Kbij/VentControl/README.md

# VentControl

Firmware for a custom made RP-2040 board with relays. Used for Ventilation control.
