Kbij/VentControl/pcb/Ventilator/R-78AA3.3-1.0SMD/R-78AA3.3-1.0SMD.step

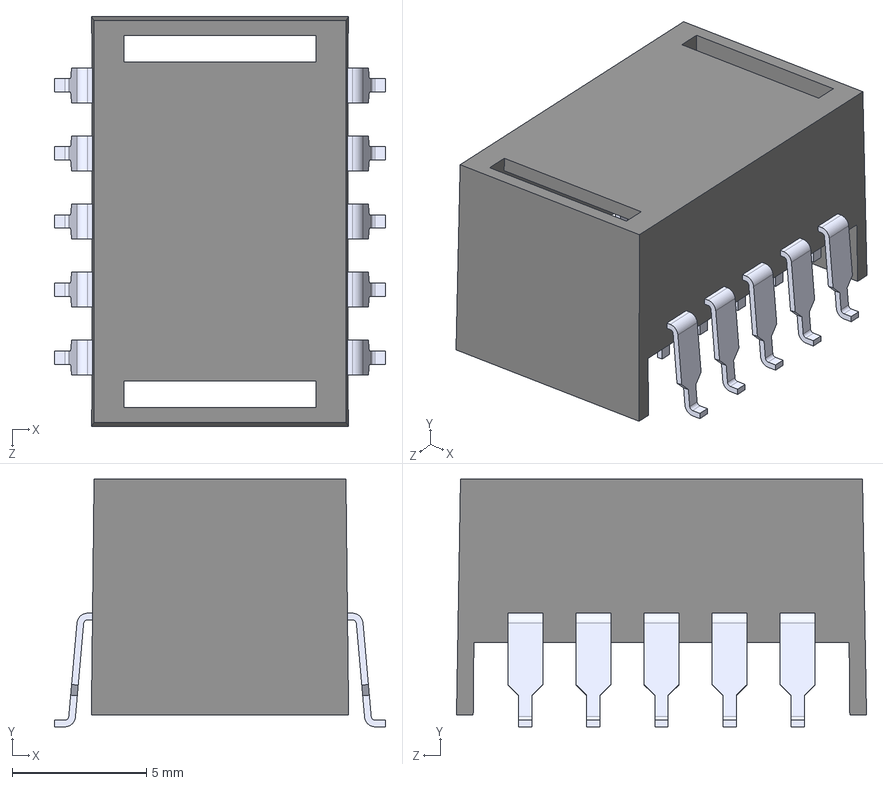
[picture p1: CAD file, 2022-12-26]
pcb/Ventilator/R-78AA3.3-1.0SMD/R-78AA3.3-1.0SMD.step
12.3 x 9.24 x 15.3 mm
