Kbij/VentControl/pcb/Ventilator/Ventilator.kicad_pcb

## KiCad design pcb/Ventilator/Ventilator.kicad_pcb (2023-04-06)

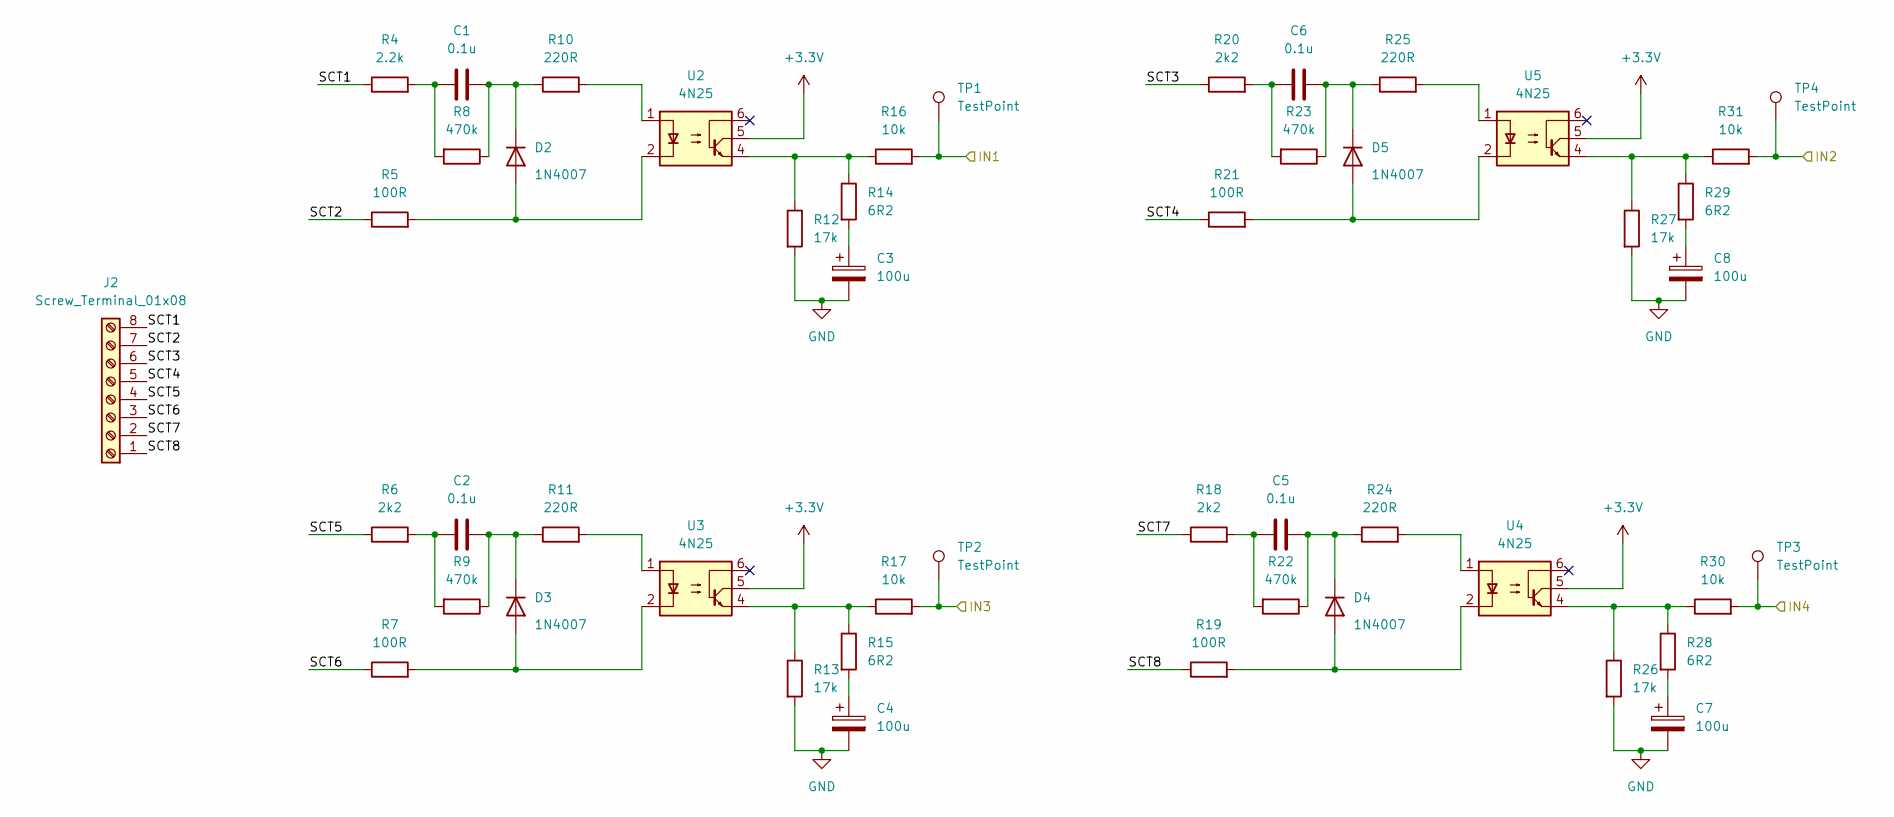
[picture p2: schematic Input.kicad_sch]

Parts:
C1, C2, C5, C6: 0.1u; C_Rect_L18.0mm_W5.0mm_P15.00mm_FKS3_FKP3
C3, C4, C7, C8: 100u; C_1206_3216Metric_Pad1.33x1.80mm_HandSolder
D2, D3, D4, D5: 1N4007; D_DO-41_SOD81_P10.16mm_Horizontal
J2: Screw_Terminal_01x08; TerminalBlock_Phoenix_MKDS-1,5-8_1x08_P5.00mm_Horizontal
R4: 2.2k; R_2512_6332Metric
R5, R7, R19, R21: 100R; R_0805_2012Metric_Pad1.20x1.40mm_HandSolder
R6, R18, R20: 2k2; R_2512_6332Metric
R8, R9, R22, R23: 470k; R_2512_6332Metric
R10, R11, R24, R25: 220R; R_0805_2012Metric_Pad1.20x1.40mm_HandSolder
R12, R13, R26, R27: 17k; R_0805_2012Metric_Pad1.20x1.40mm_HandSolder
R14, R15, R28, R29: 6R2; R_0805_2012Metric_Pad1.20x1.40mm_HandSolder
R16, R17, R30, R31: 10k; R_0805_2012Metric_Pad1.20x1.40mm_HandSolder
TP1, TP2, TP3, TP4: TestPoint; TestPoint_Bridge_Pitch2.54mm_Drill1.0mm
U2, U3, U4, U5: 4N25; DIP-6_W7.62mm

Connections:
+3.3V: U2.5, U3.5, U4.5, U5.5; also elsewhere on the board
/CPU/IN1: R16.2, TP1.1; also elsewhere on the board
/CPU/IN2: R31.2, TP4.1; also elsewhere on the board
/CPU/IN3: R17.2, TP2.1; also elsewhere on the board
/CPU/IN4: R30.2, TP3.1; also elsewhere on the board
/Input/SCT1: J2.8, R4.1; also elsewhere on the board
/Input/SCT2: J2.7, R5.1; also elsewhere on the board
/Input/SCT3: J2.6, R20.1; also elsewhere on the board
/Input/SCT4: J2.5, R21.1; also elsewhere on the board
/Input/SCT5: J2.4, R6.1; also elsewhere on the board
/Input/SCT6: J2.3, R7.1; also elsewhere on the board
/Input/SCT7: J2.2, R18.1; also elsewhere on the board
/Input/SCT8: J2.1, R19.1; also elsewhere on the board
GND: C3.2, C4.2, C7.2, C8.2, R12.2, R13.2, R26.2, R27.2; also elsewhere on the board
unnamed 30: C1.1, D2.1 (K), R8.1, R10.1; also elsewhere on the board
unnamed 31: C1.2, R4.2, R8.2; also elsewhere on the board
unnamed: C2.1, D3.1 (K), R9.1, R11.1
unnamed: C2.2, R6.2, R9.2
unnamed: C3.1, R14.2
unnamed: C4.1, R15.2
unnamed: C5.1, D4.1 (K), R22.1, R24.1
unnamed: C5.2, R18.2, R22.2
unnamed: C6.1, D5.1 (K), R23.1, R25.1
unnamed: C6.2, R20.2, R23.2
unnamed: C7.1, R28.2
unnamed: C8.1, R29.2
unnamed: D2.2 (A), R5.2, U2.2
unnamed: D3.2 (A), R7.2, U3.2
unnamed: D4.2 (A), R19.2, U4.2
unnamed: D5.2 (A), R21.2, U5.2
unnamed: R10.2, U2.1
unnamed: R11.2, U3.1
unnamed: R12.1, R14.1, R16.1, U2.4
unnamed: R13.1, R15.1, R17.1, U3.4
unnamed: R24.2, U4.1
unnamed: R25.2, U5.1
unnamed: R26.1, R28.1, R30.1, U4.4
unnamed: R27.1, R29.1, R31.1, U5.4

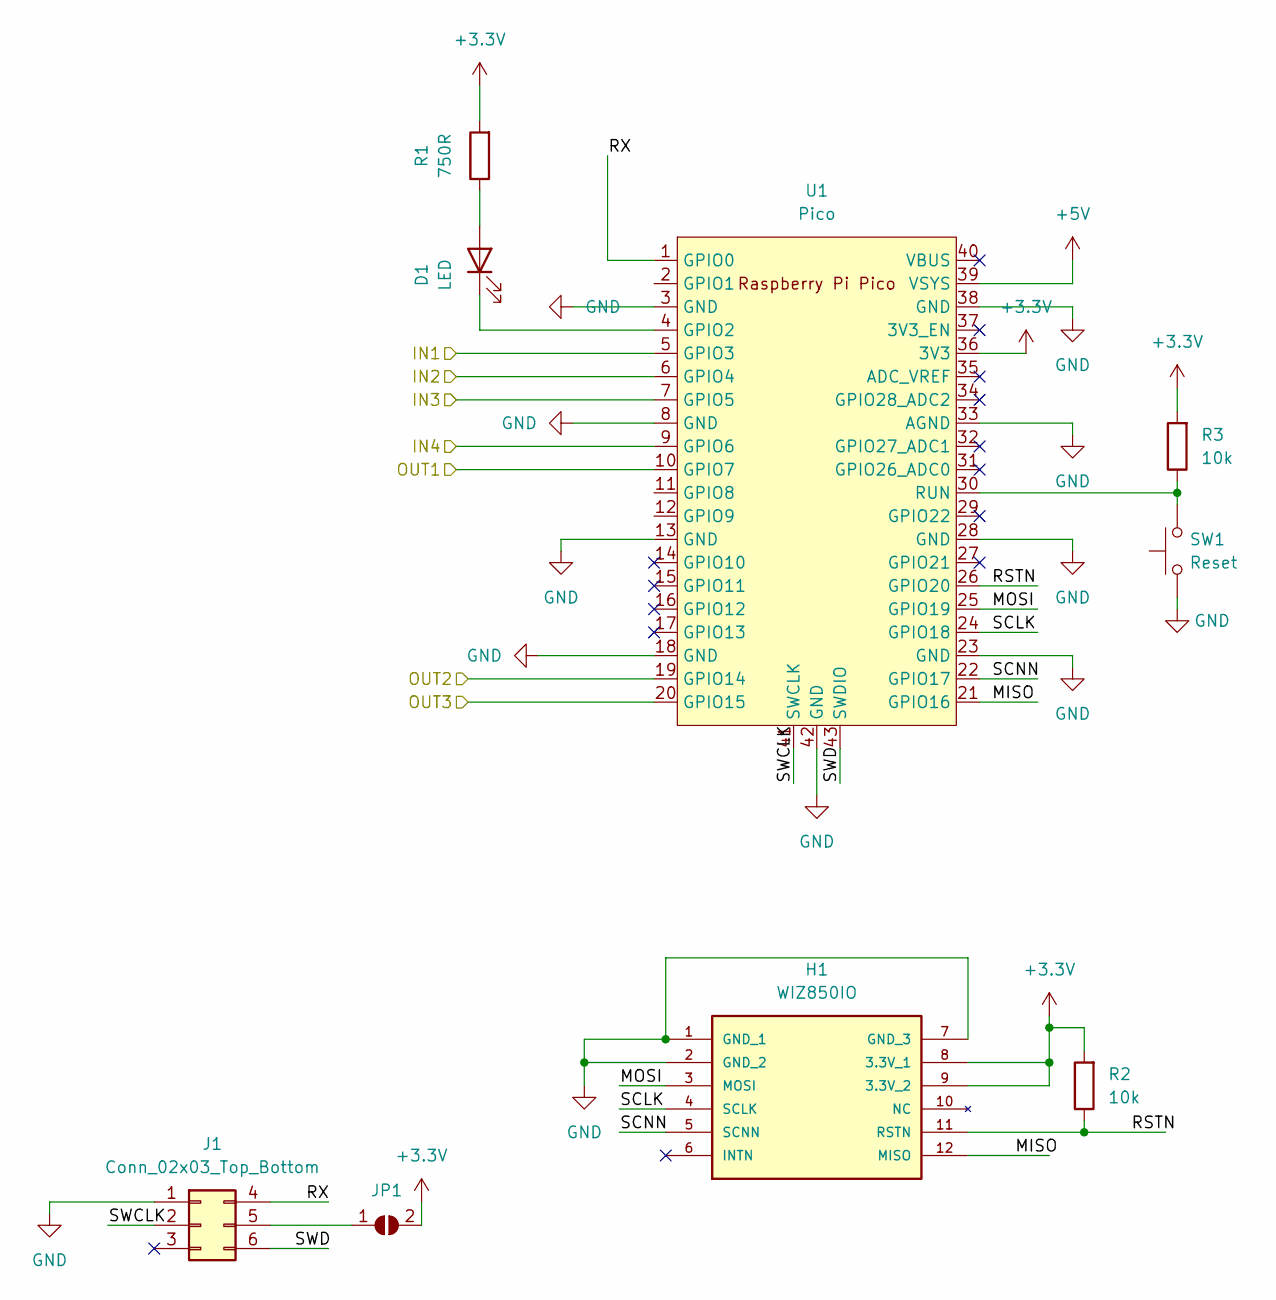
[picture p3: schematic cpu.kicad_sch]

Parts:
D1: LED; LED_D3.0mm
H1: WIZ850IO; MANUFACTURER_PART_NUMBER WIZ850IO
J1: Conn_02x03_Top_Bottom; PinHeader_2x03_P2.54mm_Vertical
JP1: SolderJumper_2_Open
R1: 750R; R_0805_2012Metric_Pad1.20x1.40mm_HandSolder
R2, R3: 10k; R_0805_2012Metric
SW1: Reset; SW_SPST_EVPBF
U1: Pico; RPi_Pico_SMD_TH

Connections:
+3.3V: H1.8 (3.3V_1), H1.9 (3.3V_2), JP1.2 (B), R1.2, R2.2, R3.2, U1.36 (3V3); also elsewhere on the board
+5V: U1.39 (VSYS); also elsewhere on the board
/CPU/IN1: U1.5 (GPIO3); also elsewhere on the board
/CPU/IN2: U1.6 (GPIO4); also elsewhere on the board
/CPU/IN3: U1.7 (GPIO5); also elsewhere on the board
/CPU/IN4: U1.9 (GPIO6); also elsewhere on the board
/CPU/MISO: H1.12 (MISO), U1.21 (GPIO16)
/CPU/MOSI: H1.3 (MOSI), U1.25 (GPIO19)
/CPU/OUT1: U1.10 (GPIO7); also elsewhere on the board
/CPU/OUT2: U1.19 (GPIO14); also elsewhere on the board
/CPU/OUT3: U1.20 (GPIO15); also elsewhere on the board
/CPU/RSTN: H1.11 (RSTN), R2.1, U1.26 (GPIO20)
/CPU/RX: J1.4, U1.1 (GPIO0)
/CPU/SCLK: H1.4 (SCLK), U1.24 (GPIO18)
/CPU/SCNN: H1.5 (SCNN), U1.22 (GPIO17)
/CPU/SWCLK: J1.2, U1.41 (SWCLK)
/CPU/SWD: J1.6, U1.43 (SWDIO)
GND: H1.1 (GND_1), H1.2 (GND_2), H1.7 (GND_3), J1.1, SW1.1, U1.3 (GND), U1.8 (GND), U1.13 (GND), U1.18 (GND), U1.23 (GND), U1.28 (GND), U1.33 (AGND), U1.38 (GND), U1.42 (GND); also elsewhere on the board
unnamed: D1.1 (K), U1.4 (GPIO2)
unnamed: D1.2 (A), R1.1
unnamed: J1.5, JP1.1 (A)
unnamed: R3.1, SW1.2, U1.30 (RUN)

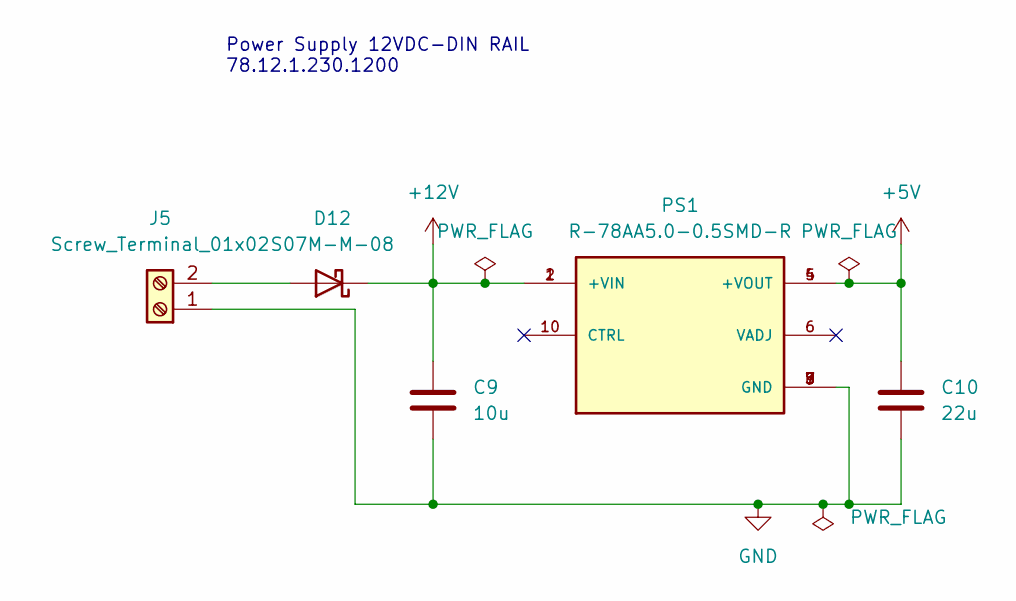
[picture p4: schematic Power.kicad_sch]

Parts:
C9: 10u; C_0805_2012Metric_Pad1.18x1.45mm_HandSolder
C10: 22u; C_0805_2012Metric_Pad1.18x1.45mm_HandSolder
D12: S07M-M-08; D_SMF
J5: Screw_Terminal_01x02; TerminalBlock_bornier-2_P5.08mm
PS1: R-78AA5.0-0.5SMD-R; CONV_R-78AA3.3-1.0SMD; PARTREV 5/2019

Connections:
+5V: C10.1, PS1.4 (+VOUT), PS1.5 (+VOUT); also elsewhere on the board
+12V: C9.1, D12.1 (K), PS1.1 (+VIN), PS1.2 (+VIN); also elsewhere on the board
GND: C9.2, C10.2, J5.1, PS1.3 (GND), PS1.7 (GND), PS1.8 (GND), PS1.9 (GND); also elsewhere on the board
unnamed: D12.2 (A), J5.2

Notes on the sheet:
Power Supply 12VDC-DIN RAIL 78.12.1.230.1200

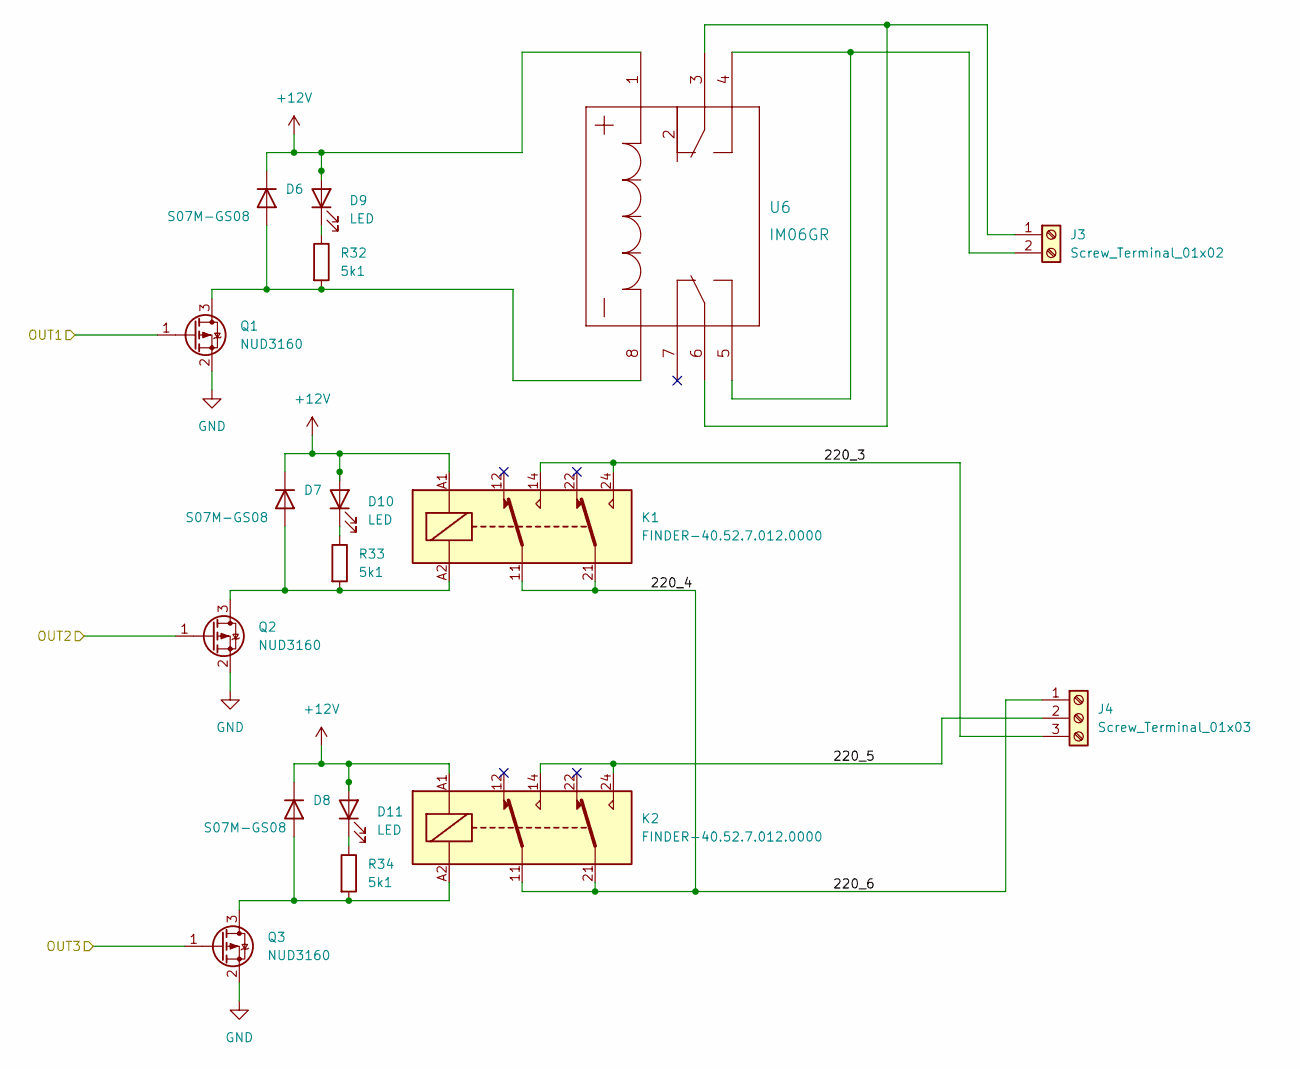
[picture p5: schematic Output.kicad_sch]

Parts:
D6, D7, D8: S07M-GS08; D_SMF
D9, D10, D11: LED; LED_D3.0mm
J3: Screw_Terminal_01x02; TerminalBlock_Phoenix_MKDS-1,5-2-5.08_1x02_P5.08mm_Horizont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
J4: Screw_Terminal_01x03; TerminalBlock_Phoenix_MKDS-1,5-3-5.08_1x03_P5.08mm_Horizont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
K1, K2: FINDER-40.52.7.012.0000; Relay_DPDT_Finder_40.52
Q1, Q2, Q3: NUD3160; SOT-23
R32, R33, R34: 5k1; R_0805_2012Metric_Pad1.20x1.40mm_HandSolder
U6: IM06GR

Connections:
+12V: D6.1 (K), D7.1 (K), D8.1 (K), D9.2 (A), D10.2 (A), D11.2 (A), K1.A1, K2.A1, U6.1; also elsewhere on the board
/CPU/OUT1: Q1.1 (G); also elsewhere on the board
/CPU/OUT2: Q2.1 (G); also elsewhere on the board
/CPU/OUT3: Q3.1 (G); also elsewhere on the board
/Output/220_3: J4.3, K1.14, K1.24
/Output/220_4: J4.1, K1.11, K1.21, K2.11, K2.21; also elsewhere on the board
/Output/220_5: J4.2, K2.14, K2.24; also elsewhere on the board
GND: Q1.2 (S), Q2.2 (S), Q3.2 (S); also elsewhere on the board
unnamed: D6.2 (A), Q1.3 (D), R32.2, U6.8
unnamed: D7.2 (A), K1.A2, Q2.3 (D), R33.2
unnamed 50: D8.2 (A), K2.A2, Q3.3 (D), R34.2; also elsewhere on the board
unnamed: D9.1 (K), R32.1
unnamed: D10.1 (K), R33.1
unnamed 53: D11.1 (K), R34.1; also elsewhere on the board
unnamed: J3.1, U6.3, U6.6
unnamed: J3.2, U6.4, U6.5

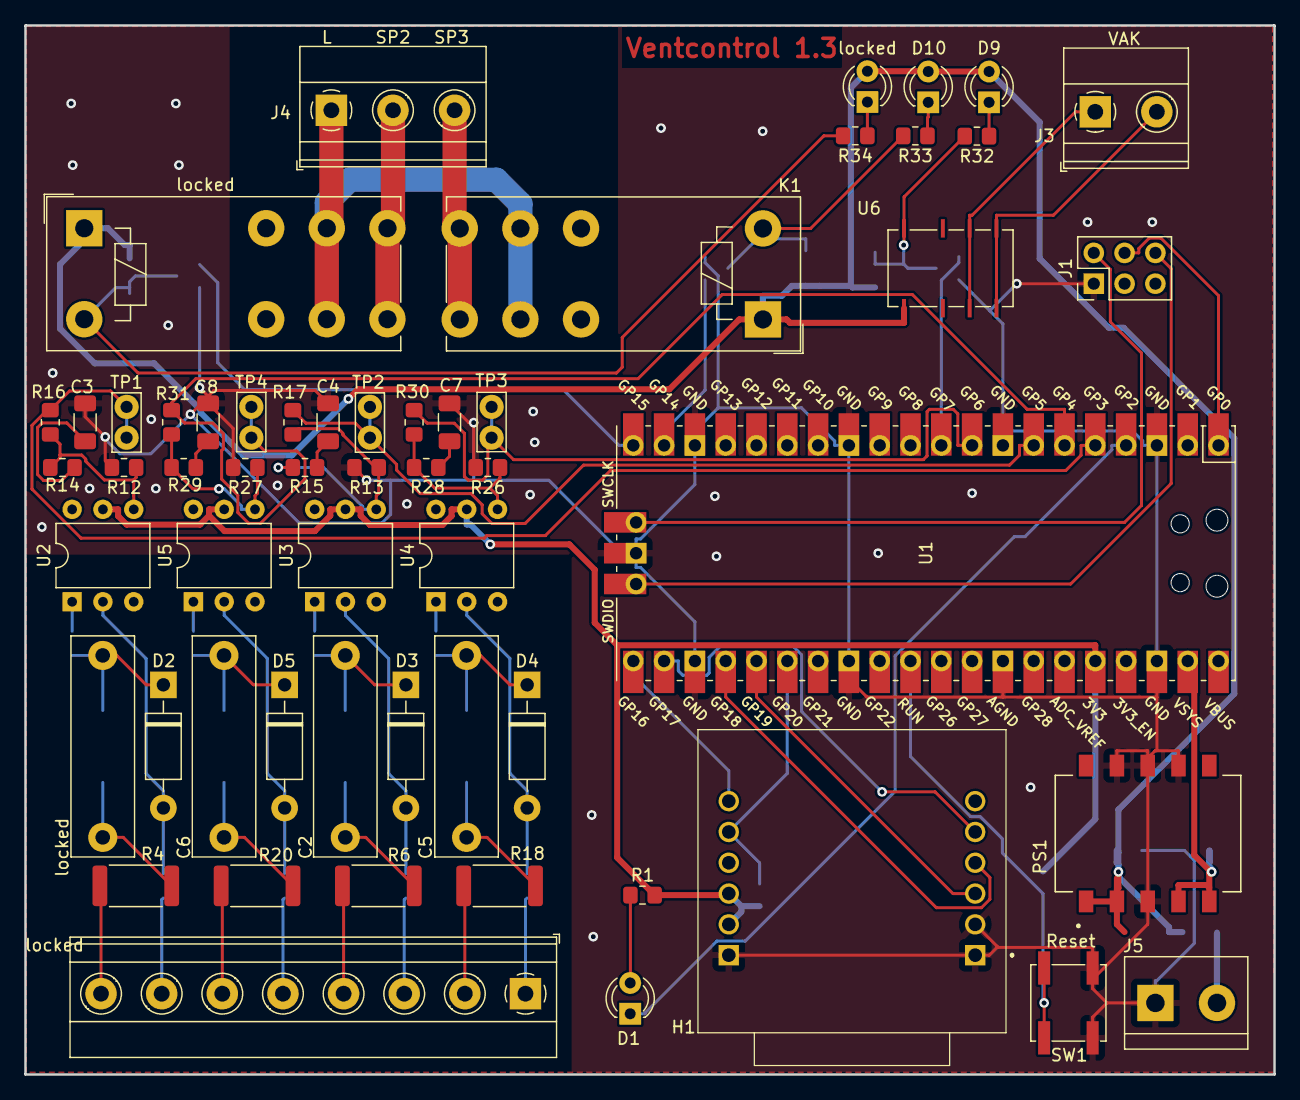
[picture p6: board Ventilator.kicad_pcb from above]

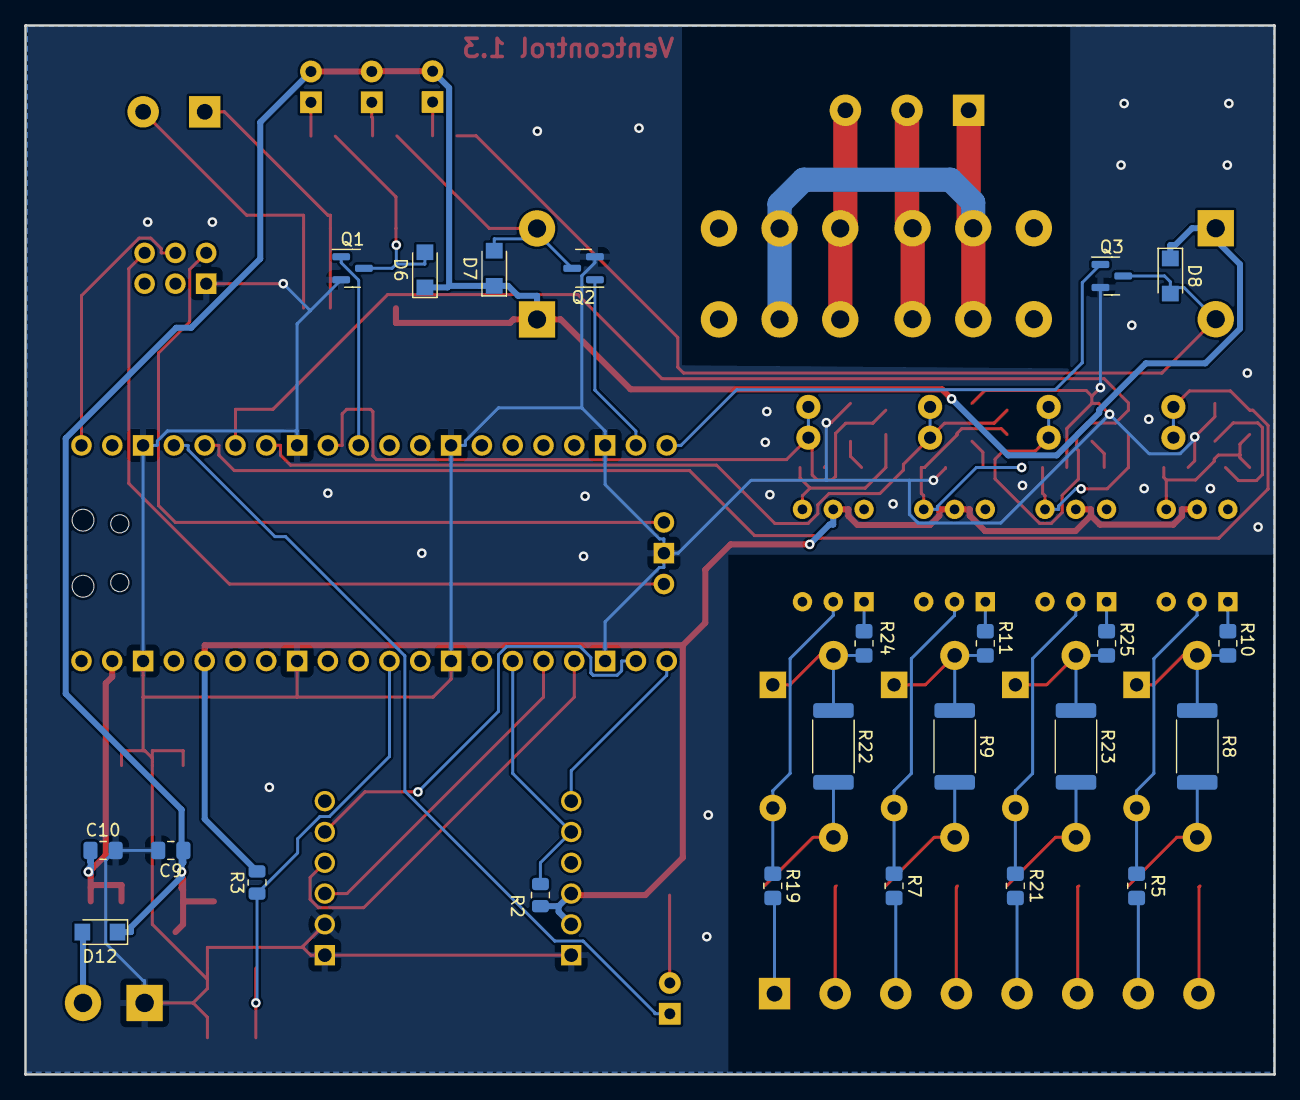
[picture p7: board Ventilator.kicad_pcb from below]

Board: 2 copper layers, 103.0 x 86.5 mm, 79 parts (23 on the bottom side), 66 nets.

Other parts of the board:
locked: Screw_Terminal_01x08; TerminalBlock_Phoenix_MKDS-1,5-8_1x08_P5.00mm_Horizontal
locked#2: FINDER-40.52.7.012.0000; Relay_DPDT_Finder_40.52
locked#3: LED; LED_D3.0mm
locked#4: 0.1u; C_Rect_L18.0mm_W5.0mm_P15.00mm_FKS3_FKP3

Their connections:
+12V: locked#2.A1, locked#3.2 (A); also elsewhere on the board
/Input/SCT1: locked.8; also elsewhere on the board
/Input/SCT2: locked.7; also elsewhere on the board
/Input/SCT3: locked.6; also elsewhere on the board
/Input/SCT4: locked.5; also elsewhere on the board
/Input/SCT5: locked.4; also elsewhere on the board
/Input/SCT6: locked.3; also elsewhere on the board
/Input/SCT7: locked.2; also elsewhere on the board
/Input/SCT8: locked.1; also elsewhere on the board
/Output/220_4: locked#2.11, locked#2.21; also elsewhere on the board
/Output/220_5: locked#2.14, locked#2.24; also elsewhere on the board
unnamed 30: locked#4.1; also elsewhere on the board
unnamed 31: locked#4.2; also elsewhere on the board
unnamed 50: locked#2.A2; also elsewhere on the board
unnamed 53: locked#3.1 (K); also elsewhere on the board
