Kbij/VentControl/firmware/src/server.h

#ifndef B05D9526_ED76_4381_A517_160F0993D8C9
#define B05D9526_ED76_4381_A517_160F0993D8C9

#define LISTENING_PORT          1234
#define LISTENING_SOCKET_COUNT  4
#define BASE_PORT_ID            2
#define KEEP_ALIVE_SECONDS      10
#define TIMEOUT_SECONDS         30


void server_task(void* params);

#endif /* B05D9526_ED76_4381_A517_160F0993D8C9 */
