Kbij/VentControl/(commit log)

2022-10-03 -components placed
    [Ventilator.kicad_pcb, Ventilator.kicad_sch]
2022-10-04 - as send to JCLPCB
    [Ventilator.kicad_pcb, Ventilator.kicad_sch]
2022-10-22 - resister values
    [Ventilator.csv, Ventilator.kicad_sch]
2022-12-26 - added rp2040, multiple sheets, etc...
    [Input.kicad_sch, Output.kicad_sch, Power.kicad_sch, R-78AA3.3-1.0SMD.step, Ventilator.kicad_pcb, Ventilator.kicad_sch, cpu.kicad_sch]
2022-12-28 - all parts connected, placed partially
    [Input.kicad_sch, Output.kicad_sch, Power.kicad_sch, Ventilator.kicad_pcb, Ventilator.kicad_sch, cpu.kicad_sch]
2022-12-30 - voor omschakeling naar rp pico
    [Input.kicad_sch, Output.kicad_sch, Power.kicad_sch, Ventilator.kicad_pcb, Ventilator.kicad_sch, cpu.kicad_sch]
2022-12-30 - voor autorouter
    [Input.kicad_sch, Output.kicad_sch, Power.kicad_sch, Ventilator.kicad_pcb, Ventilator.kicad_sch, cpu.kicad_sch]
2022-12-30 - as ordered (30/12/2022)
    [Input.kicad_sch, Output.kicad_sch, Power.kicad_sch, Ventilator.kicad_pcb, Ventilator.kicad_sch, cpu.kicad_sch]
2023-01-14 -relais working. close socket has issue
    [server.c, types.h, ventcontrol.c]
2023-01-14 - fix hang on close
    [server.c, ventcontrol.c]
2023-01-19 -cleanup ventcontrol.c (has bug)
    [ventcontrol.c]
2023-01-19 - fix issue with duplicate ventcontrol task
    [main.c, server.c, ventcontrol.c]
2023-01-29 - fix hang ?
    [server.c, types.h, ventcontrol.c]
2023-01-30 -Ventcontrol 1.2 (routed)
    [Input.kicad_sch, Output.kicad_sch, Power.kicad_sch, Ventilator.kicad_pcb, Ventilator.kicad_sch, cpu.kicad_sch]
2023-01-31 - last changes
    [Output.kicad_sch, Ventilator.kicad_pcb]
2023-02-18 - small change in gnd plane
    [Ventilator.kicad_pcb]
2023-04-06 - as ordered
    [Input.kicad_sch, Output.kicad_sch, Power.kicad_sch, Ventilator.kicad_pcb, Ventilator.kicad_sch, cpu.kicad_sch]
